OpenDrone-hw/OpenFrame-3F/images/kit.png

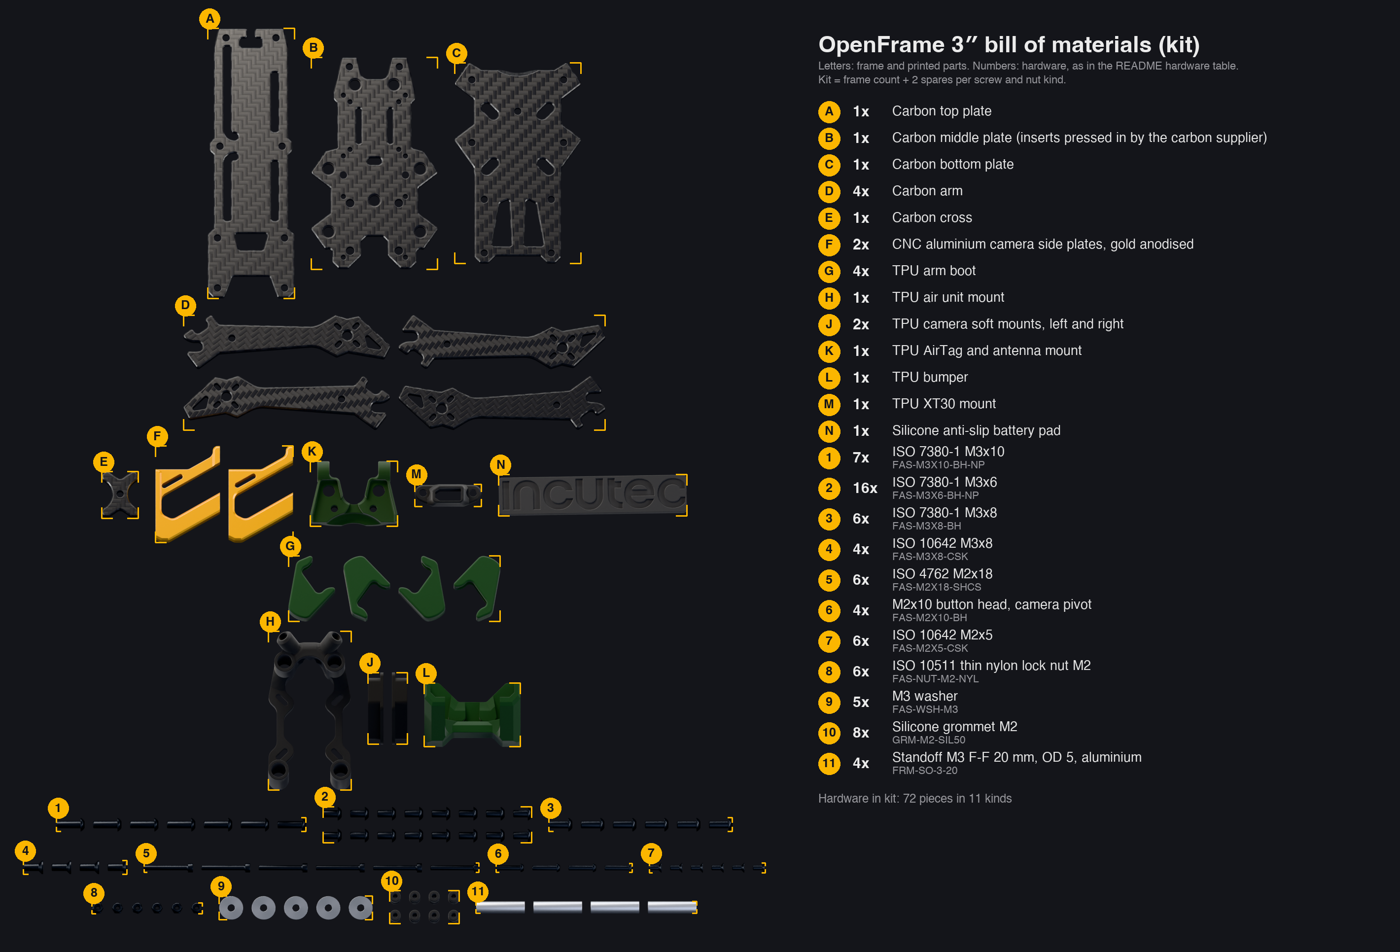
images/kit.png
