OpenDrone-hw/OpenFrame-3F/images/top.png

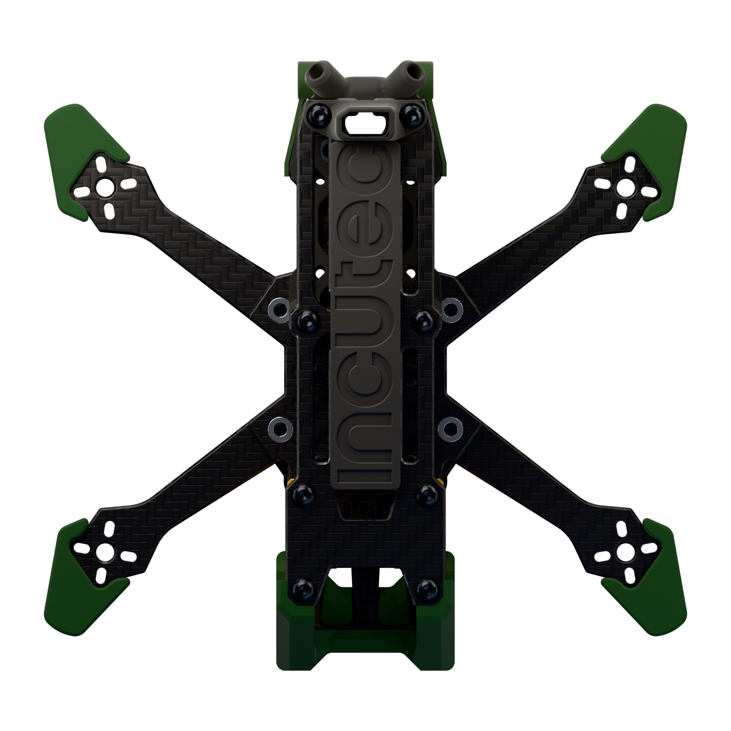
images/top.png
