OpenDrone-hw/OpenFrame-3F/images/parts/acc-frm-bot-3.png

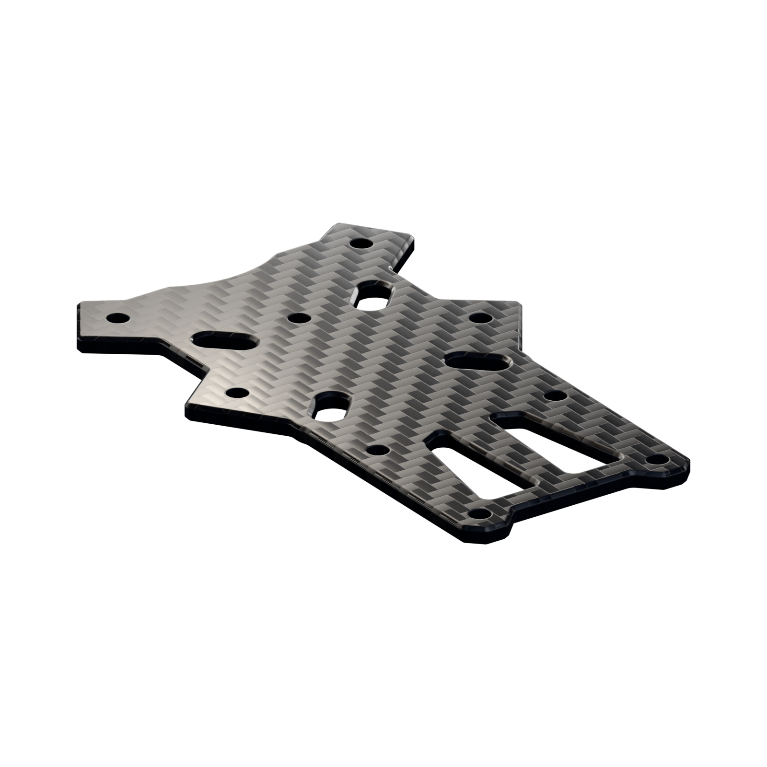
images/parts/acc-frm-bot-3.png
