OpenDrone-hw/OpenFrame-3F/images/parts/acc-frm-cam-3.png

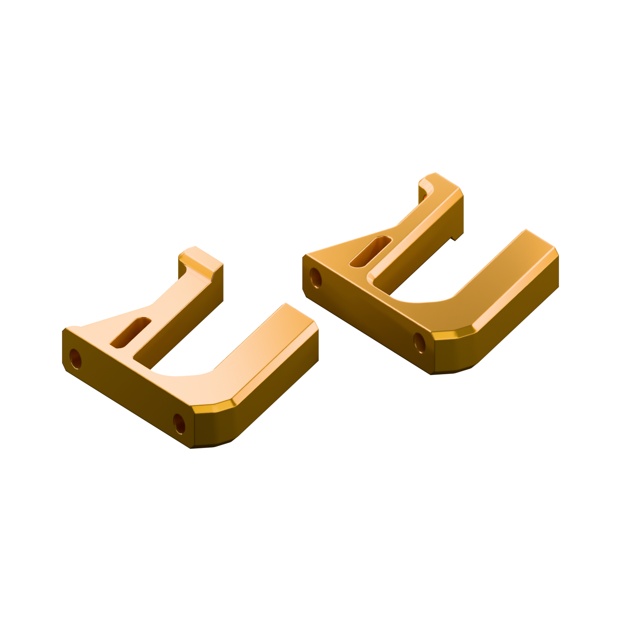
images/parts/acc-frm-cam-3.png
