OpenDrone-hw/OpenFrame-3F/images/parts/acc-frm-hw-3.png

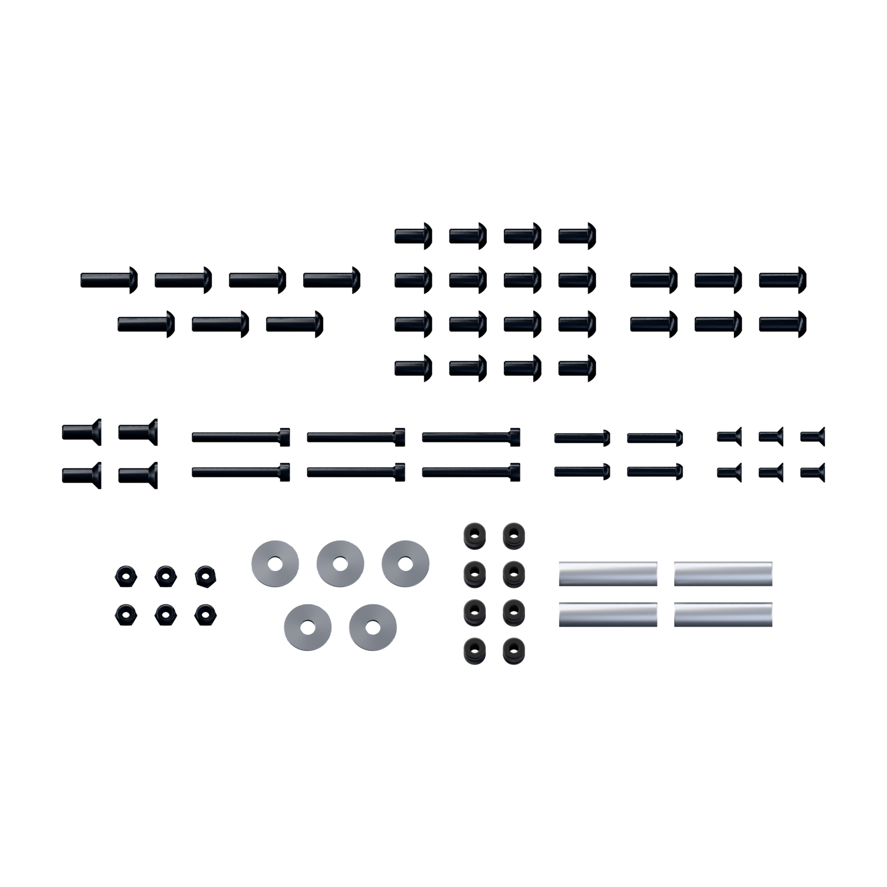
images/parts/acc-frm-hw-3.png
