OpenDrone-hw/OpenFrame-3F/releases/rev2.2/step/Base-Top.step

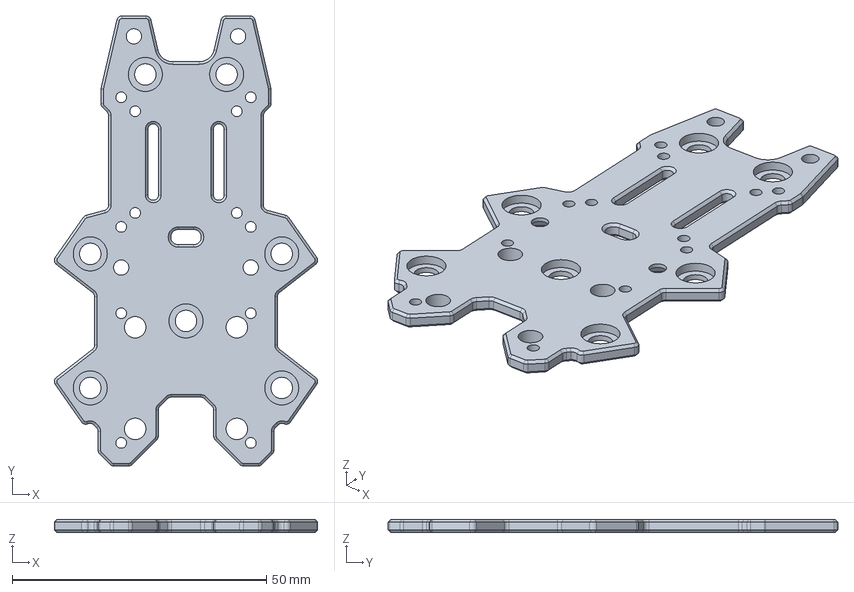
[picture p8: CAD file, 2026-10-24]
releases/rev2.2/step/Base-Top.step
51.8 x 88.5 x 2.50 mm
