OpenDrone-hw/OpenFrame-3F/releases/rev2.2/step/Airtag-Antenna-Mount.step

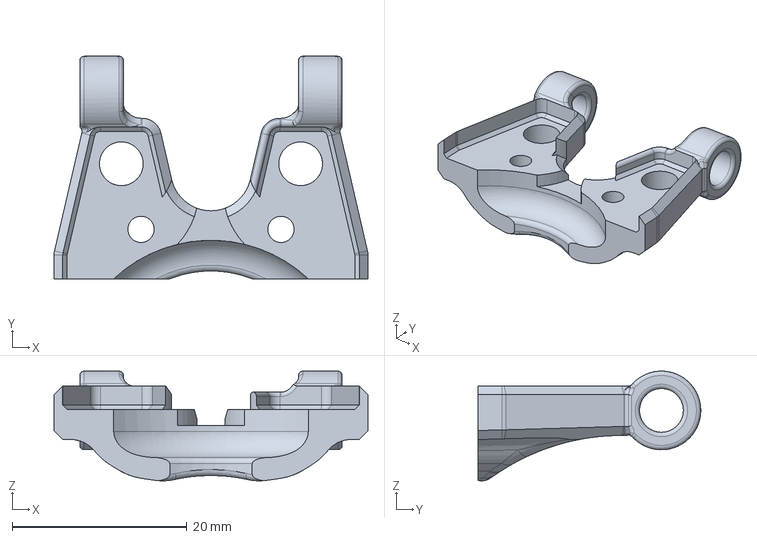
[picture p9: CAD file, 2026-10-24]
releases/rev2.2/step/Airtag-Antenna-Mount.step
35.9 x 25.5 x 12.6 mm
