OpenDrone-hw/OpenFrame-3F/releases/rev2.2/step/Cam-Mount-L.step

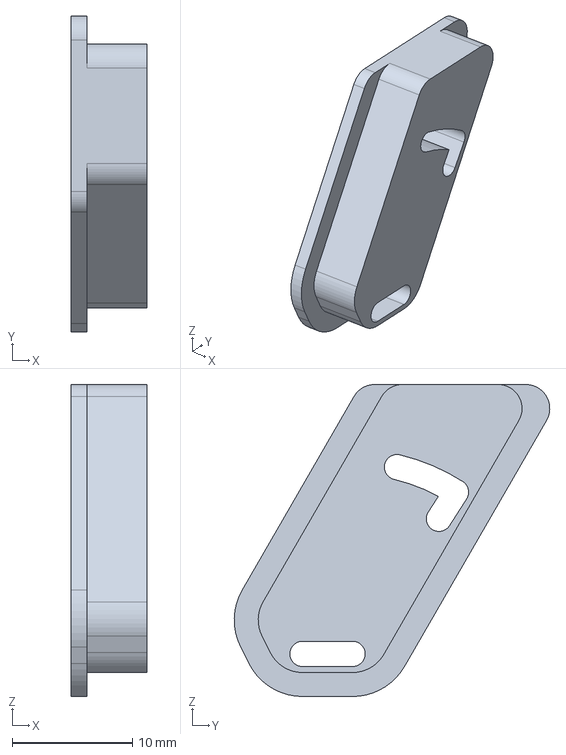
[picture p10: CAD file, 2026-10-24]
releases/rev2.2/step/Cam-Mount-L.step
6.30 x 26.3 x 26.0 mm
