OpenDrone-hw/OpenFrame-3F/releases/rev2.2/step/Base-Bot.step

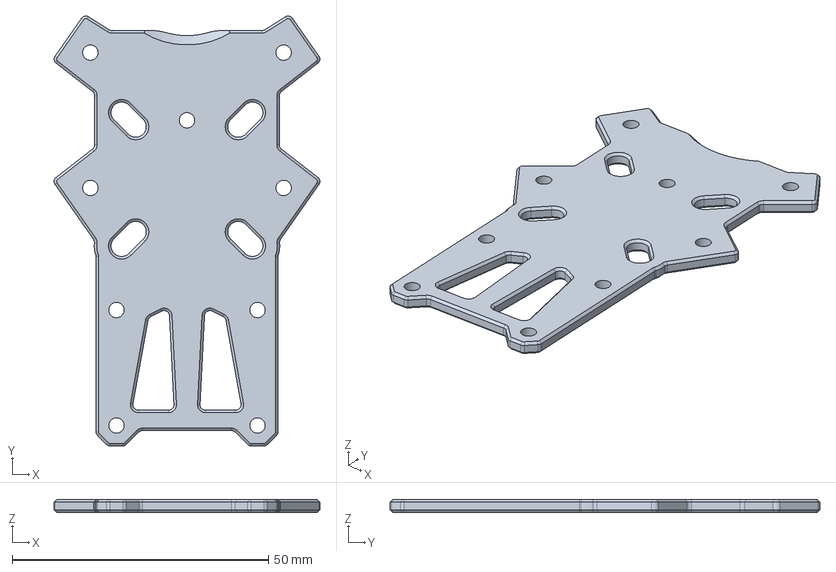
[picture p11: CAD file, 2026-10-24]
releases/rev2.2/step/Base-Bot.step
51.8 x 83.8 x 2.50 mm
