OpenDrone-hw/OpenFrame-3F/releases/rev2.2/step/Standoff-M3-F-F-20-OD5.step

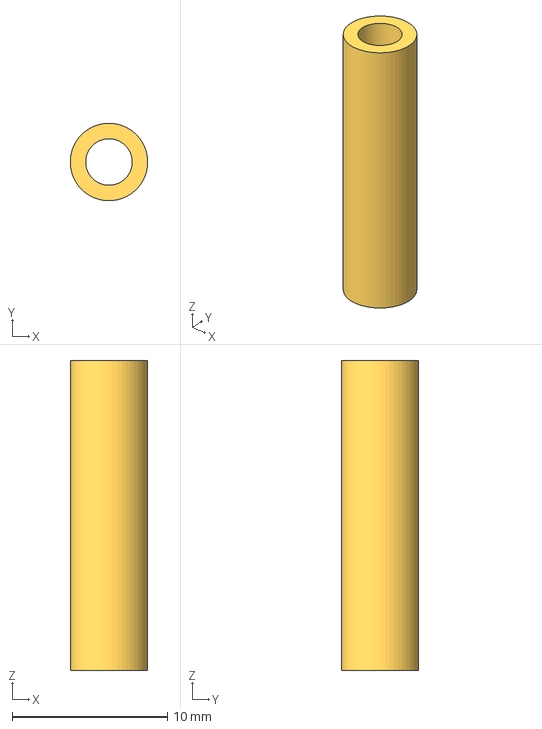
[picture p12: CAD file, 2026-10-24]
releases/rev2.2/step/Standoff-M3-F-F-20-OD5.step
5.00 x 5.00 x 20.0 mm
