OpenDrone-hw/OpenFrame-3F/releases/rev1/step/Standoff-L.step

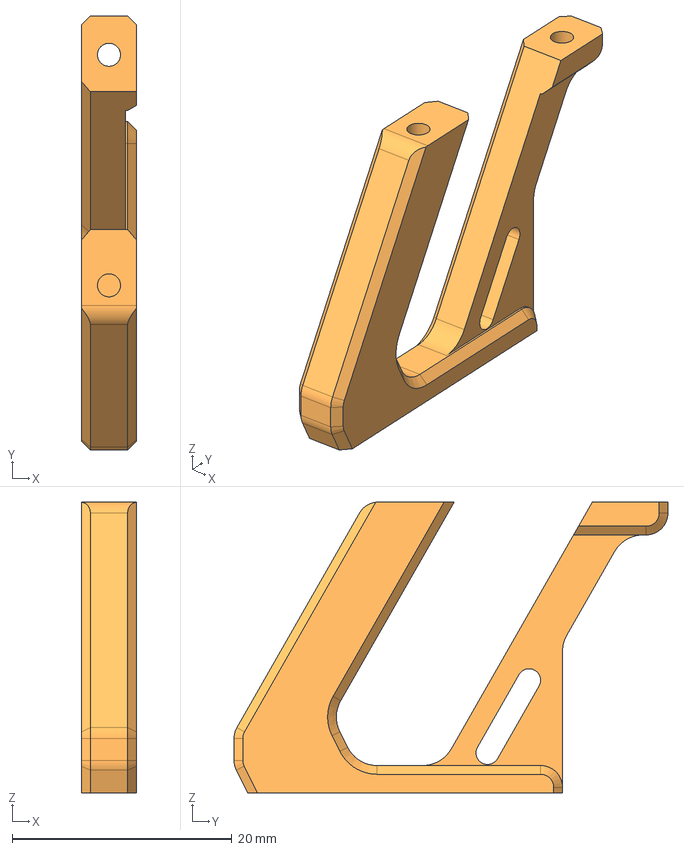
[picture p13: CAD file, 2026-10-23, an earlier design]
releases/rev1/step/Standoff-L.step
5.00 x 39.5 x 26.5 mm
