OpenDrone-hw/OpenFrame-3F/releases/rev2/step/bootFL.step

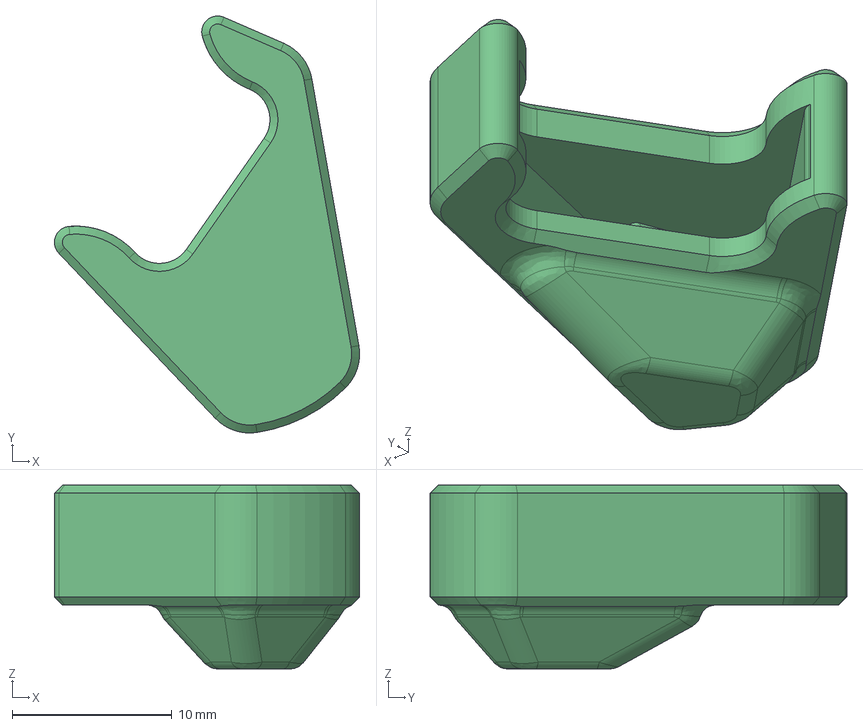
[picture p14: CAD file, 2026-10-23, an earlier design]
releases/rev2/step/bootFL.step
19.1 x 26.1 x 11.5 mm
