OpenDrone-hw/OpenFrame-3F/releases/rev1/step/Airtag-Antenna-Mount.step

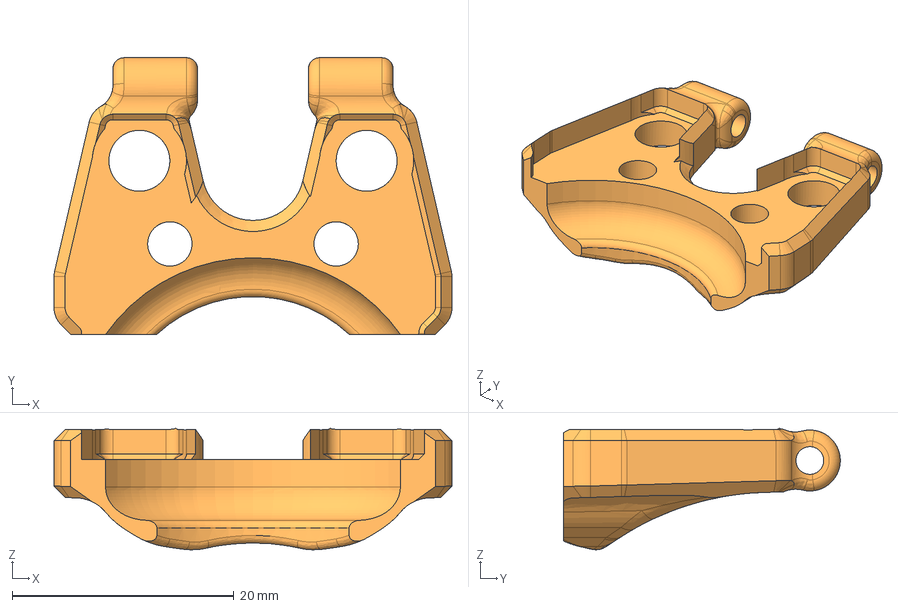
[picture p15: CAD file, 2026-10-23, an earlier design]
releases/rev1/step/Airtag-Antenna-Mount.step
35.9 x 25.0 x 11.0 mm
