OpenDrone-hw/OpenFrame-3F/releases/rev1/step/VTX-Mount.step

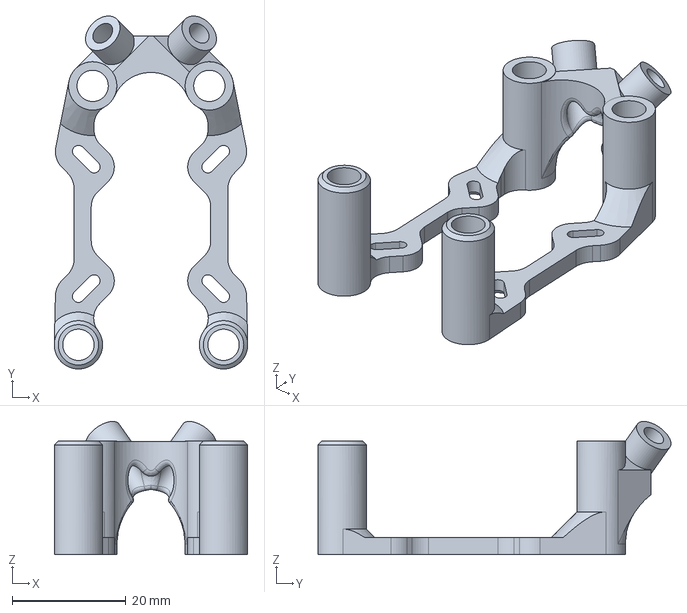
[picture p16: CAD file, 2026-10-23, an earlier design]
releases/rev1/step/VTX-Mount.step
34.0 x 62.0 x 23.4 mm
