OpenDrone-hw/OpenFrame-3F/releases/rev1/step/Base-Bot.step

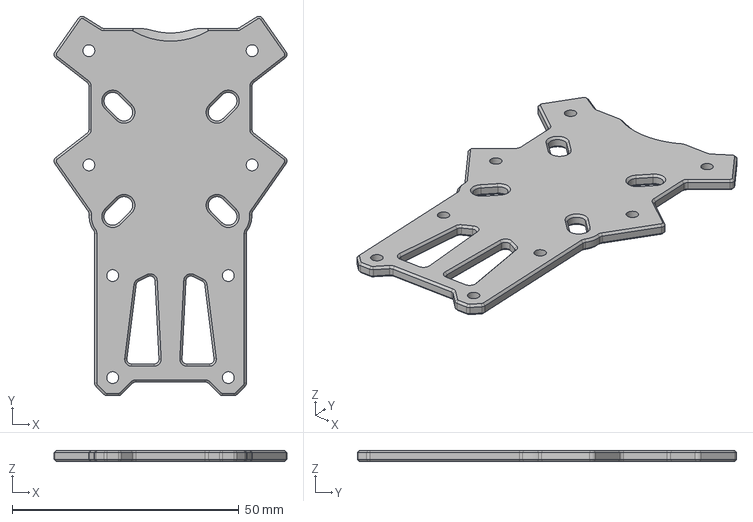
[picture p17: CAD file, 2026-10-23, an earlier design]
releases/rev1/step/Base-Bot.step
51.4 x 83.7 x 2.50 mm
