OpenDrone-hw/OpenFrame-3F/releases/rev1/step/Base-Top.step

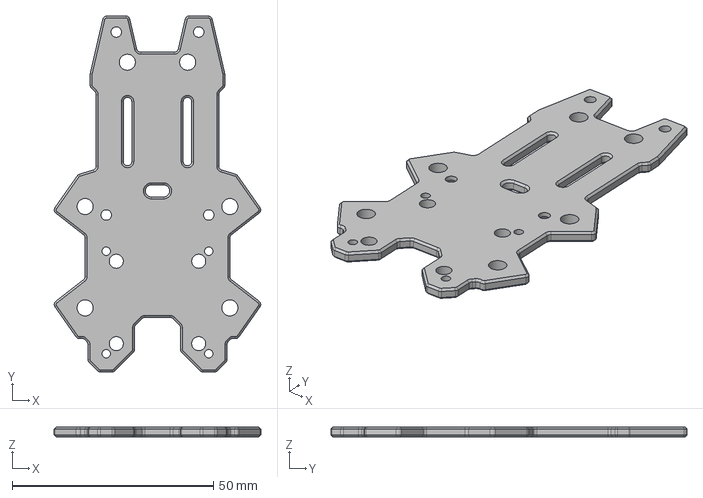
[picture p18: CAD file, 2026-10-23, an earlier design]
releases/rev1/step/Base-Top.step
51.4 x 88.5 x 2.50 mm
