OpenDrone-hw/OpenFrame-3F/releases/rev1/step/Cam-Mount.step

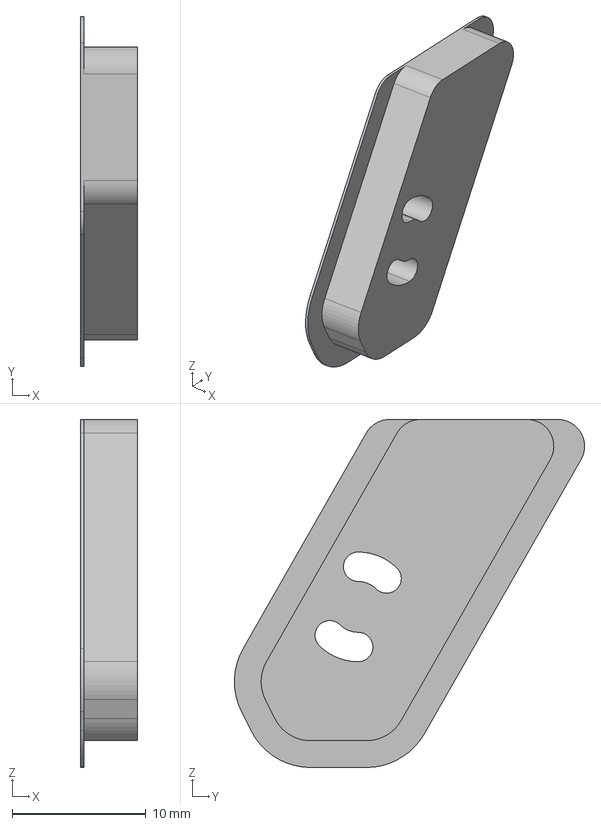
[picture p19: CAD file, 2026-10-23, an earlier design]
releases/rev1/step/Cam-Mount.step
4.25 x 26.2 x 26.0 mm
