OpenDrone-hw/OpenFrame-3F/releases/rev1/step/Boot-R.step

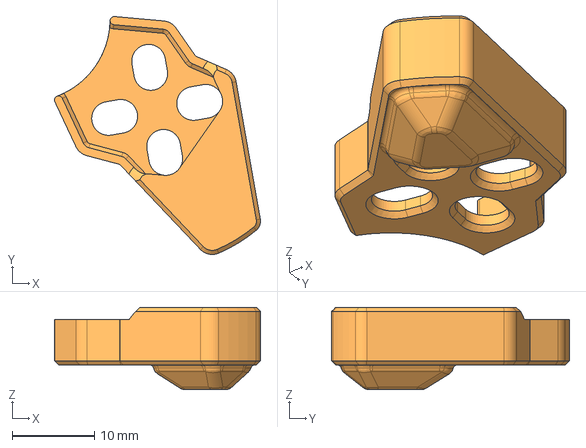
[picture p20: CAD file, 2026-10-23, an earlier design]
releases/rev1/step/Boot-R.step
25.1 x 28.9 x 10.0 mm
