OpenDrone-hw/OpenFrame-3F/(list of files, cad)

Other CAD files:
releases/rev2/step/20mmx4mm.step
releases/rev2/step/Base-Bot.step
releases/rev2/step/Cam-Mount-R.step
releases/rev2/step/bootRR.step
releases/rev2/step/bootFR.step
releases/rev1/step/20mmx4mm.step
releases/rev1/step/Cross.step
releases/rev1/step/Standoff-R.step
releases/rev2/step/Airtag-Antenna-Mount.step
releases/rev2/step/Arm.step
releases/rev2/step/Base-Top.step
