OpenDrone-hw/OpenFrame-3F/releases/rev1/drawings/Drawing-1.pdf

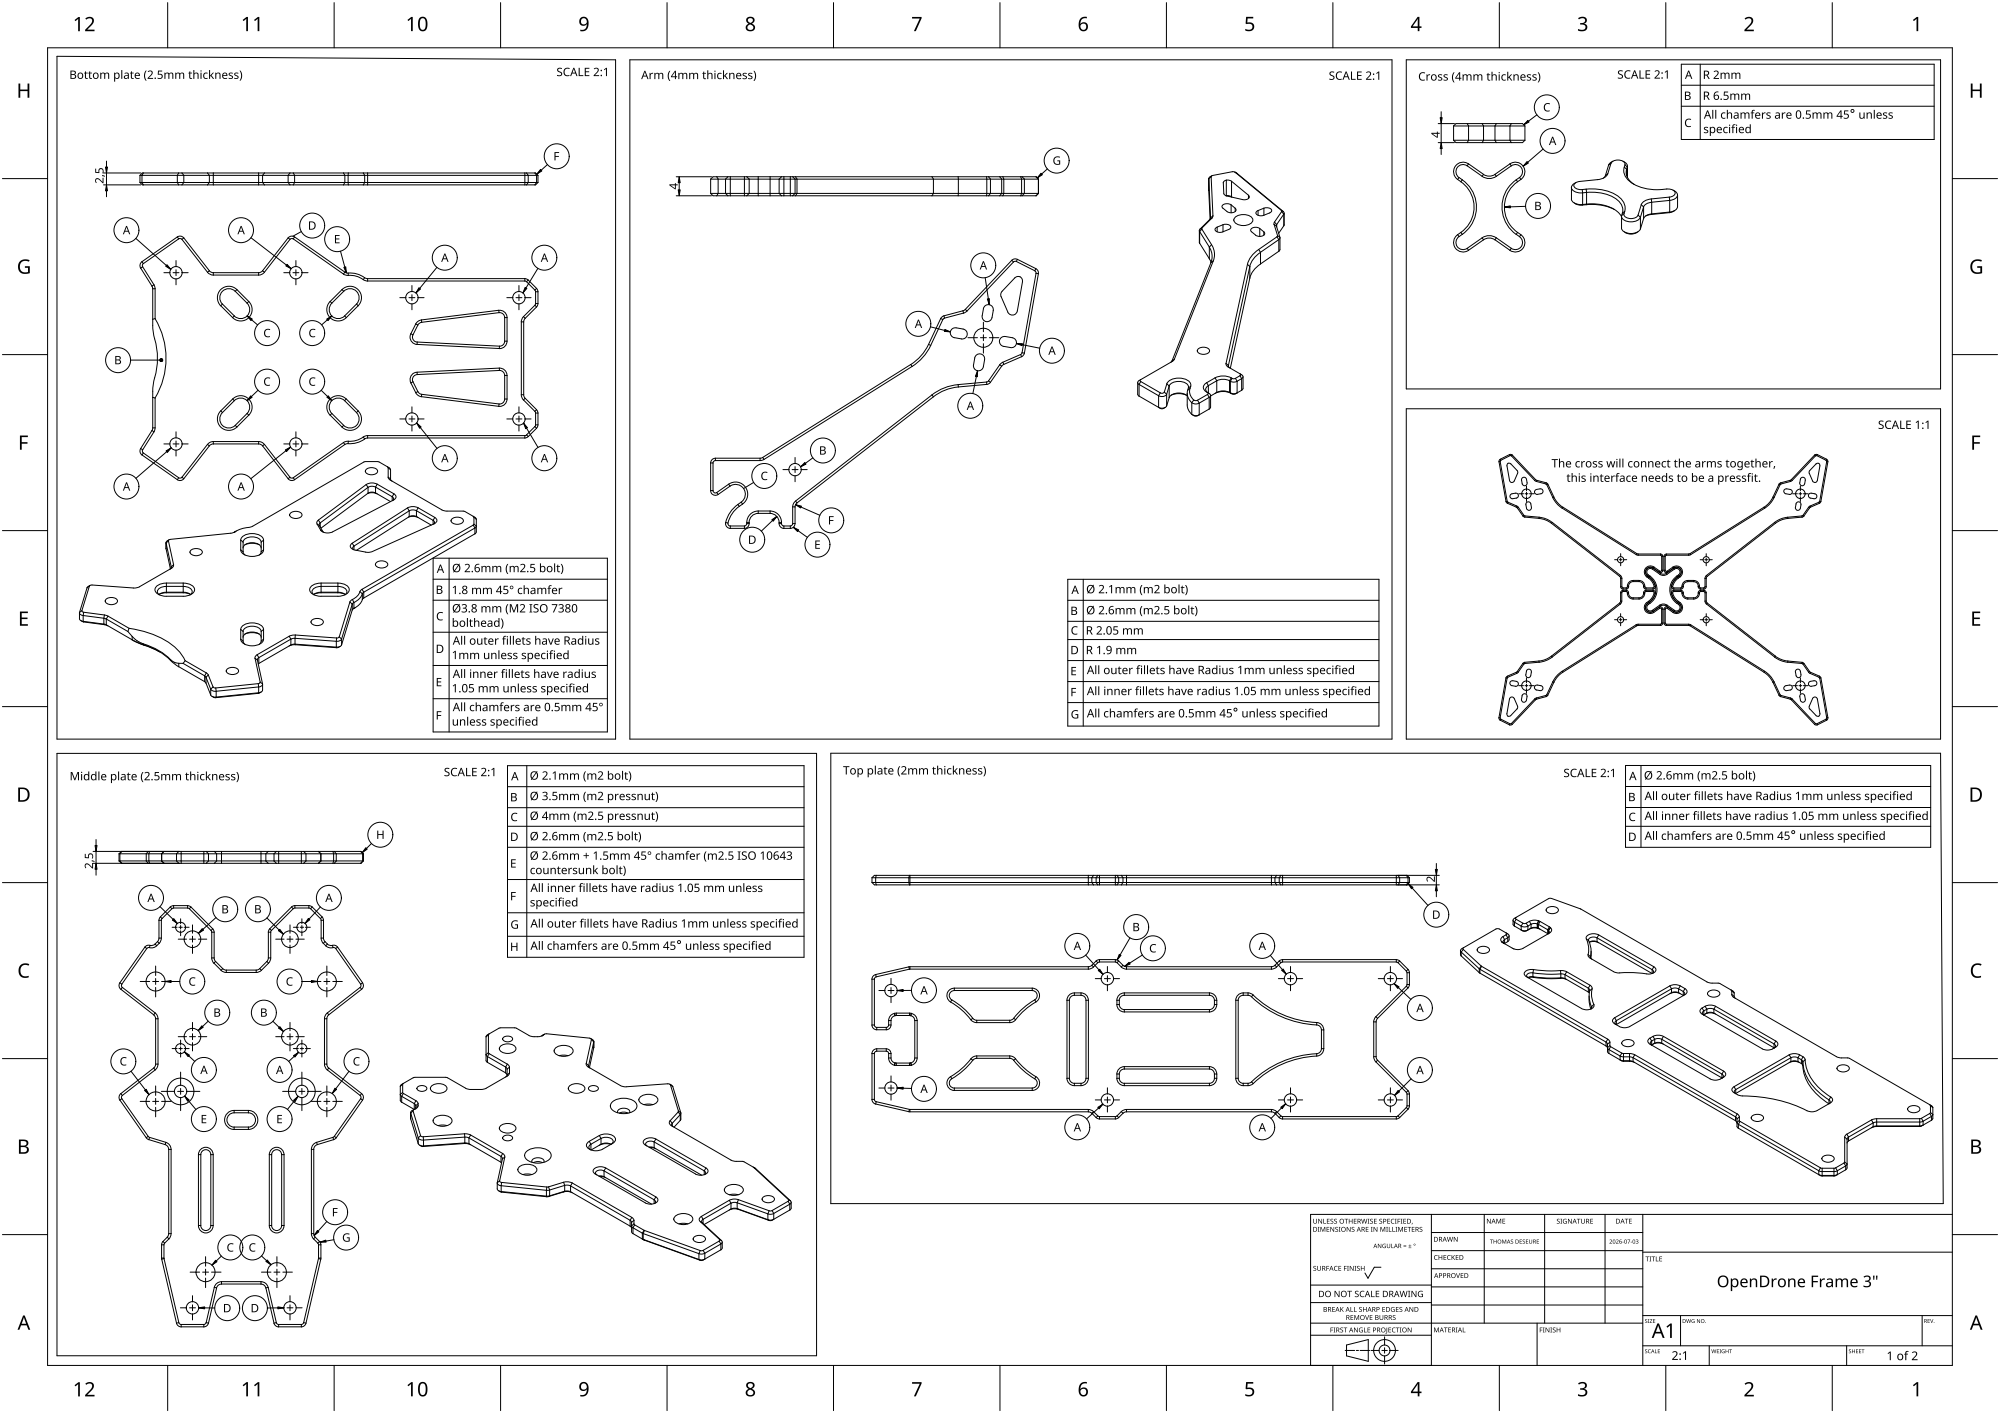
[picture p21: page 1]

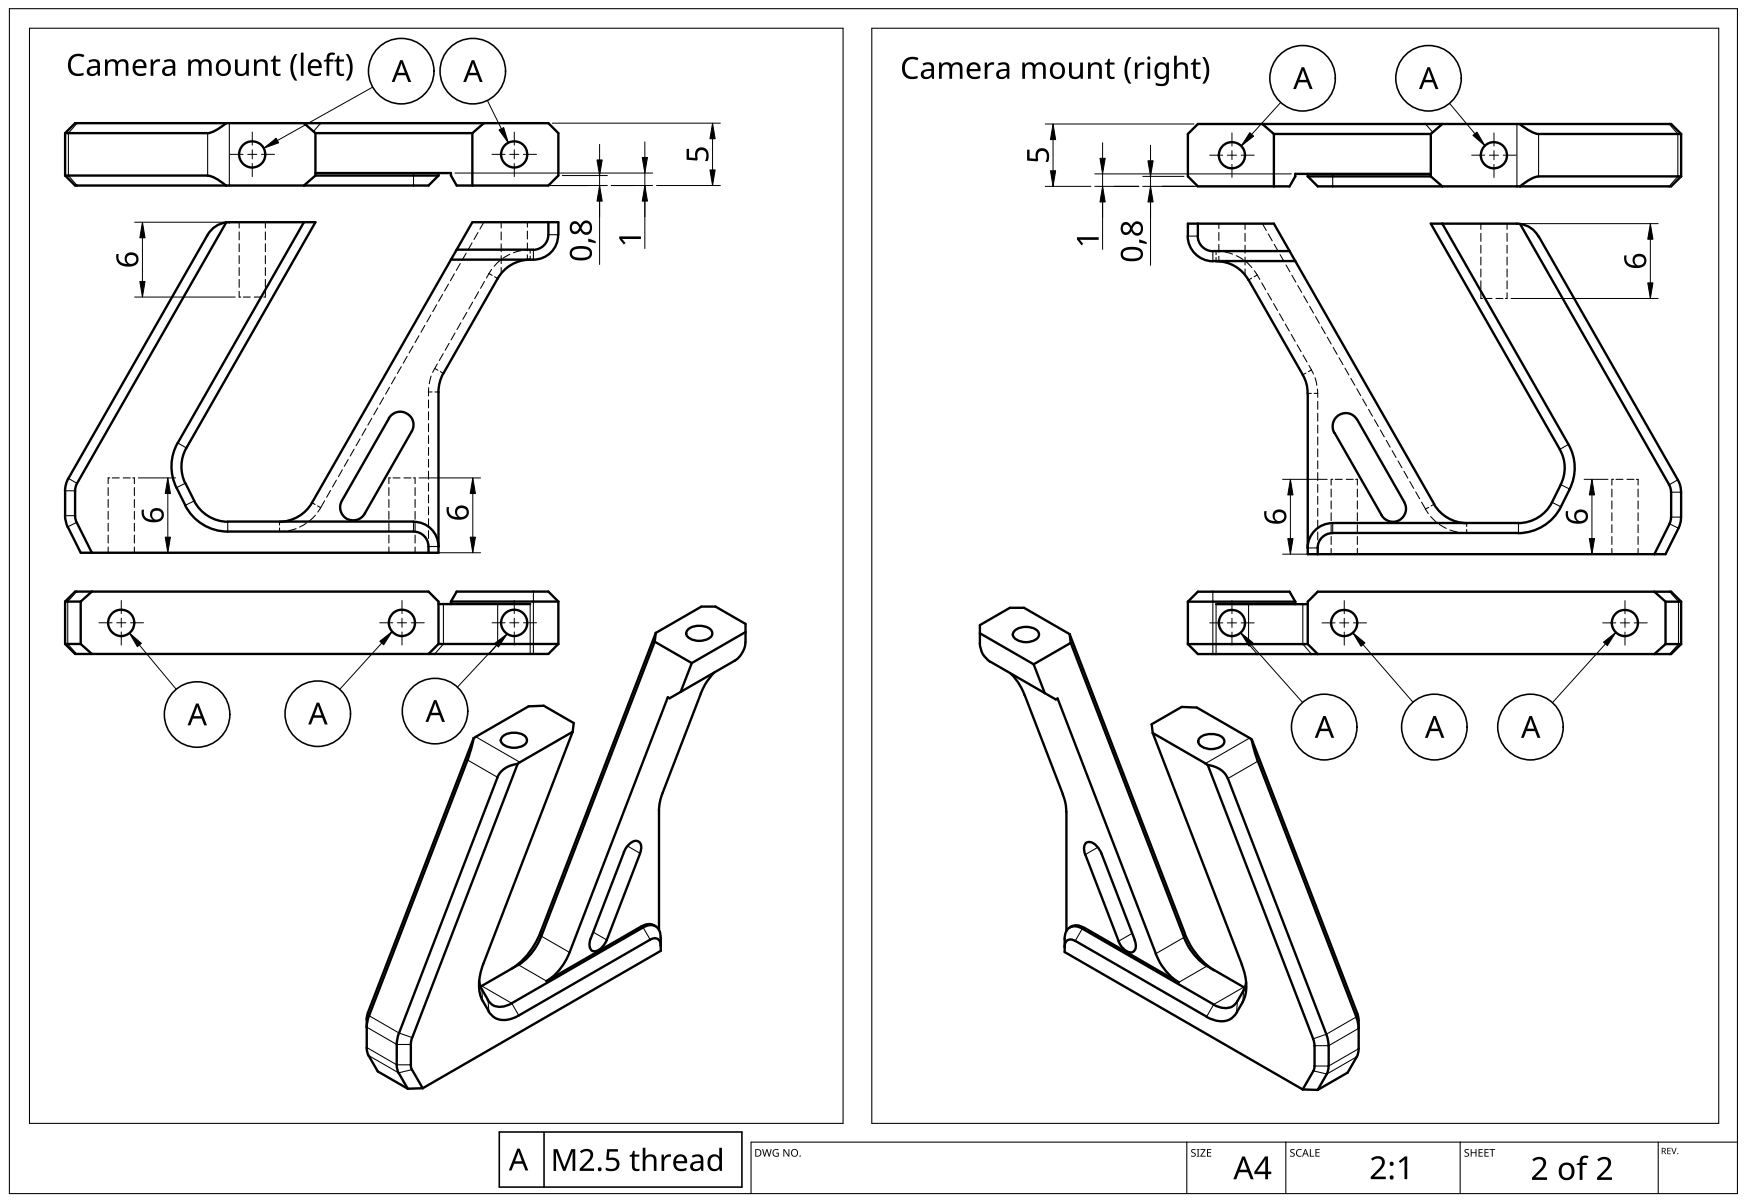
[picture p22: page 2]
