OpenDrone-hw/OpenFrame-3F/(commit log)

2026-09-25 Set up OpenFrame-3F as a mechanical repository (#1)
    Follows the Incutec mechanical repository template: the Onshape source is
    linked from cad/onshape.json, parts.csv and hardware.csv list a set as the
    Onshape assembly has it, releases/ will hold the exports, and the README
    shows the model and its open checks.
    [OpenDrone-6L.kicad_pcb, OpenDrone-6L.kicad_sch, board.kicad_pcb, board.kicad_sch, hardware.csv, parts.csv]
2026-09-25 Fix the README flowchart: an inch mark closed the label early (#2)
2026-09-25 Map the carbon plates to their SKUs and thicknesses (#4)
    Top, Base-Top and Base-Bot are the top, middle and bottom plates: measured
    thickness and stacking order in the Onshape Part Studio match the last
    released drawing.
    [parts.csv]
2026-09-25 Record TPU and silicone and the agent branch model checks (#5)
    Printed parts are TPU (library entry Polyurethane) and the pad is
    silicone (Silicone Rubber) in parts.csv and the README set table.
    cad/onshape.json names the Onshape branch agent/model-checks-3in under agentBranch.
    The Model checks table is regenerated with --agent-branch.
    [parts.csv]
2026-09-30 Drop the reference to a supplier pack in a private tag (#7)
    OpenFrame-3F goes public. The README pointed at a tag of OpenFrame-5F that holds
    supplier material. The sentence is removed; releases/ is empty so no drawing
    has been released from this repository.
    Removes: one README sentence.
2026-09-30 Remove the frame's personal owner name and the sourcing pointer (#8)
    cad/onshape.json names a role instead of a person in the document owner
    field (the release and fit tools read the owner from the Onshape API and
    only print this file's value). The README diagram no longer ends in a
    supplier node. AGENTS.md carries the durable sourcing rule.
    Removes: the owner's personal name from HEAD, the Suppliers node.
2026-10-10 cad: refresh link file and parts lists to the 2026-10-09 Onshape snapshot (#10)
    Part ids, names, hardware set and README model checks follow the live CAD.
    Measured carbon and side plate thicknesses added. Document owner is Incutec BV.
    Motor screws are not frame hardware.
2026-10-10 docs: key dimensions from measured 3" geometry (#11)
    Bolt and press-nut hole rows now match the 2026-10-09 CAD geometry:
    Ø2.1/Ø2.9 thread-grip holes, 7x M3 press-nut seats with recess, and
    the M3 countersinks on Base-Top. Removes the stale M2.5 values.
2026-10-12 docs(agents): cut AGENTS.md to validate, boundaries, pointers (#12)
    AGENTS.md 18 -> 16 lines. Removes architecture, tables, procedures and
    state; keeps only hard boundaries and the validation command.
    Claude-Session: https://claude.ai/code/session_017Ye54fa9v5VP179Xbw465R
2026-10-13 docs: restore AGENTS.md technical write-up (#13)
    Reverts the AGENTS.md cut and the README pointer change; the write-up is board documentation, not duplicated elsewhere.
    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
2026-10-13 docs(agents): drop the KiCad board Rules section (#15)
    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
2026-10-23 release: rev1 (2026-07-05 samples) and rev2 (2026-10-20 batch 1), changelog (#16)
    * release: rev1, the 2026-07-05 state the first CNC samples were cut from
    Onshape version 'OpenFrame-3F rev1', created from document history.
    * release: rev2, the 2026-10-20 state for the first production batch
    * docs: changelog per revision, hardware lists and README to rev2
    * docs: rev G changes in the workspace (unreleased), model review and hardware spec
    hardware.csv keeps the Onshape counts and now names what each screw does and
    what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
2026-10-23 cad: link file and parts.csv to the rev3 part ids (#17)
    Onshape re-numbered 17 parts with the rev G edits (2026-10-21): the standoff,
    both side plates and the printed parts. Ids read from version OpenFrame-3F rev3
    (352840010b1250ee813124d3). The part named m2.5 pressnut in the link file is
    named m3 pressnut in the model.
2026-10-23 docs: rev3 and the Onshape fix branches in the changelog (#18)
    The model review table now says what is done on the Onshape fix branch and what
    is open. The 5 McMaster screws are part of the DJI O4 Pro reference model, not
    leftovers: corrected.
2026-10-24 release: rev2.2, final CNC parts and hardware (#19)
    * cad: follow the Onshape branch 3in-fixes (not merged in Onshape)
    The link file points its agentBranch at 3in-fixes (from version rev3).
    hardware.csv lists what the branch holds: ISO 7380 M3x12 arm screws, ISO 4762
    M2x20 stack screws with ISO 10511 nylon lock nuts, ISO 10642 countersunk
    screws, 7 M3 inserts, every standard screw class 12.9 black. The standoff and
    grommet carry their new part names.
    * docs: fact-check fixes (batch wording, finish, xt30 screw mate, README follows the branch)
    The first production frame batch is quoted on rev3, not ordered; rev2 is
    handoff rev F. The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
2026-10-24 README: assembled and exploded renders side by side (#20)
2026-10-24 releases/rev2.2: middle-plate nut holes for catalogue self-clinching nuts, camera-mount hole depths (#21)
    Exported from Onshape version OpenFrame-3F rev2.2 (workspace 3in-fixes).
    Base-Top: M2/M3 4.22, M3 seat 6.7 x 1.55. Standoff-L/R: tapped hole depths as set by the founder.
    All other parts geometrically identical to the earlier rev2.2 export; their files are kept.
2026-10-26 docs: bring README, CHANGELOG and bom.csv in line with the rev2.2 handoff package (#22)
    Self-clinching nuts, bolt hole tolerance +0.10/0, press fit, anti-slip pad rev B note, screw-length re-check marked open where ambiguous.
